xjordanx/q-radio/(commit log)

2024-09-23 Start Praline design based on HackRF One r10
    [baseband.kicad_sch, frontend.kicad_sch, mcu.kicad_sch, praline.kicad_sch]
2024-09-30 Replace CPLD U24 with FPGA U16
    [baseband.kicad_sch, fpga.kicad_sch, frontend.kicad_sch, mcu.kicad_sch, praline.kicad_sch]
2024-09-30 Change PCB stack-up from four layers to six layers
2024-09-30 Update hardware version detection pin strap
    [mcu.kicad_sch]
2024-10-01 Change USB connector J1 to Type-C
    [fpga.kicad_sch, mcu.kicad_sch]
2024-10-01 Remove interior mounting holes
    [frontend.kicad_sch]
2024-10-01 Remove unused headers
    [baseband.kicad_sch, mcu.kicad_sch]
2024-10-01 Improve voltage regulator layout
    [baseband.kicad_sch, mcu.kicad_sch]
2024-10-01 Add slow-start to VAA power switch
    This fixes "the glitch" previously worked around in firmware.
    [baseband.kicad_sch, fpga.kicad_sch, frontend.kicad_sch, mcu.kicad_sch]
2024-10-02 Change main crystal X1 to TCXO
    [baseband.kicad_sch]
2024-10-02 Update ESD diode component selection
    [baseband.kicad_sch, frontend.kicad_sch]
2024-10-02 Clean up minor ERC violations
    [baseband.kicad_sch, fpga.kicad_sch, frontend.kicad_sch, mcu.kicad_sch]
2024-10-03 Add GND zone to front and back layers
2024-10-03 Update component selections
    [baseband.kicad_sch, fpga.kicad_sch, frontend.kicad_sch, mcu.kicad_sch]
2024-10-04 Update SMA connector component and footprint
    [baseband.kicad_sch, frontend.kicad_sch]
2024-10-16 Remove test points from RF section
    [baseband.kicad_sch, frontend.kicad_sch]
2024-10-16 Use 0201s in RF section
    - Use 1 uF capacitors for DC blocking and decoupling
    - Use 3.3 nF capacitors on switch control signals
    [baseband.kicad_sch, fpga.kicad_sch, frontend.kicad_sch, mcu.kicad_sch]
2024-10-17 Correct FPGA_SGPIO signal labels
    [fpga.kicad_sch]
2024-10-25 Clean up radio layout
    [adc-dac.kicad_sch, baseband.kicad_sch, fpga.kicad_sch, frontend.kicad_sch, mcu.kicad_sch, mixer.kicad_sch, praline.kicad_sch]
2024-10-25 Add current limit for antenna port power
    Use pair of inductors as RF choke
    [baseband.kicad_sch, frontend.kicad_sch]
2024-10-25 Fix FPGA VCCPLL source connection
    [fpga.kicad_sch]
2024-11-09 Adopt new convention for DNP designation
    [baseband.kicad_sch, frontend.kicad_sch, mcu.kicad_sch]
2024-11-09 Drive SGPIO clock (SGPIO8) with FPGA
    Previously the clock generator produced three sample clocks, one at the
    sample rate for the AFE (ADC/DAC) also routed to the FPGA, one at double
    the sample rate for SGPIO, and a duplicate SGPIO clock routed to the
    FPGA. Now the clock generator produces only the AFE clock. The FPGA
    drives the SGPIO clock, derived from the AFE clock.
    [adc-dac.kicad_sch, baseband.kicad_sch, fpga.kicad_sch, mcu.kicad_sch]
2024-11-10 Make clock source termination consistent
    [adc-dac.kicad_sch, baseband.kicad_sch, clock.kicad_sch, fpga.kicad_sch, frontend.kicad_sch, mcu.kicad_sch, mixer.kicad_sch, praline.kicad_sch]
2024-12-14 Change microcontroller U23 to LPC4330FET180
    [baseband.kicad_sch, clock.kicad_sch, fpga.kicad_sch, mcu.kicad_sch, mixer.kicad_sch, praline.kicad_sch]
2024-12-14 Change FPGA pin assignments for direct PLL input
    [fpga.kicad_sch]
2024-12-14 Increase outermost DC block to 25 V
    [clock.kicad_sch, fpga.kicad_sch, frontend.kicad_sch, mcu.kicad_sch]
2024-12-14 Use single 15 uH inductor as RF choke
    [frontend.kicad_sch, mixer.kicad_sch]
2024-12-14 Change IF baluns to HHM1946A1
    [baseband.kicad_sch]
2024-12-17 Add overvoltage protection
    [baseband.kicad_sch, fpga.kicad_sch, mcu.kicad_sch, power.kicad_sch, praline.kicad_sch]
2024-12-19 Add more expansion pins
    [clock.kicad_sch, mcu.kicad_sch, praline.kicad_sch]
2024-12-19 Change RF amplifiers U13 and U25 to TRF37C73
    [frontend.kicad_sch]
2024-12-22 Rearrange RF section
    - Use DPDT RF switches to reduce long tracks
    - Add limiter
    - Add switch control logic
    - Move ADC/DAC U18 to RF area
    - Remove baseband header P9
    [adc-dac.kicad_sch, baseband.kicad_sch, clock.kicad_sch, fpga.kicad_sch, frontend.kicad_sch, mcu.kicad_sch, mixer.kicad_sch, power.kicad_sch]
2024-12-22 Ensure LEDs can remain off in low power modes
    - Change "3V3" LED to "MCU" LED4
    - Change "1V2" LED to "FPGA" on 3V3FPGA
    - Make LED control signals active-low
    [mcu.kicad_sch]
2024-12-23 Add current-limiting switch to expansion interface
    [mcu.kicad_sch, power.kicad_sch, praline.kicad_sch]
2024-12-23 Update USB D+/D- TVS and improve routing
    [mcu.kicad_sch]
2024-12-24 Add Type-C controller
    [mcu.kicad_sch, praline.kicad_sch, usb.kicad_sch]
2025-02-05 Change U17 from MAX2837 to MAX2831
    Update version to 0.2.0+
    [adc-dac.kicad_sch, baseband.kicad_sch, clock.kicad_sch, fpga.kicad_sch, frontend.kicad_sch, mcu.kicad_sch, mixer.kicad_sch, power.kicad_sch]
2025-02-08 Change Type-C controller U29 to HUSB328
    - Update USB TVS
    - Improve USB differential impedance
    [mcu.kicad_sch, mixer.kicad_sch, power.kicad_sch, praline.kicad_sch, usb.kicad_sch]
2025-02-11 Change SMA connectors to A-SMA-KE-16.5A
    [clock.kicad_sch, frontend.kicad_sch]
2025-02-12 Change RTC crystal X3 to XKXGI-SUA-32.768K
    [mcu.kicad_sch]
2025-02-12 Consolidate PMOS component selection
    [power.kicad_sch]
2025-02-16 Multiplex clock I/O signals
    - Allow switching of CLKIN and CLKOUT ports to trigger I/O and other signals
    - Add SCT_CLK
    [baseband.kicad_sch, clock.kicad_sch, mcu.kicad_sch, praline.kicad_sch, switch_control.kicad_sch]
2025-02-17 Use lumped element filters for image rejection
    [frontend.kicad_sch]
2025-02-18 Add narrowband anti-aliasing filter
    [adc-dac.kicad_sch, mcu.kicad_sch, praline.kicad_sch]
2025-02-19 Improve baseband TX attenuation options
    [adc-dac.kicad_sch, mcu.kicad_sch, praline.kicad_sch]
2025-02-19 Add TX_EN solder jumper
    [switch_control.kicad_sch]
2025-02-19 Add IF filters
    [frontend.kicad_sch]
2025-02-19 Move USB connector J1 to match HackRF One position
2025-02-20 Connect mixer U4 LD and ENBL pins to MCU
    [adc-dac.kicad_sch, baseband.kicad_sch, clock.kicad_sch, frontend.kicad_sch, image_reject.kicad_sch, mcu.kicad_sch, mixer.kicad_sch, praline.kicad_sch]
2025-02-21 Remove GND zone from front layer F.Cu
    [mcu.kicad_sch, praline.kicad_sch]
2025-02-23 Adjust position of FPGA U16
    [mcu.kicad_sch]
2025-02-24 Move clock generator U19 to 3V3FPGA supply
    [clock.kicad_sch]
2025-02-25 Remove big/little decoupling from ADC/DAC U18
    [adc-dac.kicad_sch]
2025-02-26 Cut vacated area from PCB edge
2025-02-26 AC-couple RX analog baseband
    [adc-dac.kicad_sch, mixer.kicad_sch]
2025-02-28 Increase series resistors to 100 ohms
    [fpga.kicad_sch]
2025-02-28 Improve power supply filtering and decoupling
    [adc-dac.kicad_sch, baseband.kicad_sch, clock.kicad_sch, fpga.kicad_sch, frontend.kicad_sch, image_reject.kicad_sch, mcu.kicad_sch, mixer.kicad_sch]
2025-02-28 Move clock voltage dividers out of shielded area
2025-02-28 Adjust shield footprint for improved routing
    [frontend.kicad_sch]
2025-03-01 Update TVS
    [clock.kicad_sch, frontend.kicad_sch, usb.kicad_sch]
2025-03-03 Update tactile switch SW1, SW2 footprint
    [mcu.kicad_sch]
2025-04-12 Increase VCC from 3.25 V to 3.33 V
    [power.kicad_sch]
2025-04-12 Do not populate narrowband anti-aliasing filter
    [adc-dac.kicad_sch]
2025-04-12 Do not populate baseband DC block
    [adc-dac.kicad_sch]
2025-04-12 Do not populate TXIF attenuator
    [baseband.kicad_sch]
2025-04-15 Reduce antenna bias current limit to 125 mA
    Change all 162k resistors to 180k
    [frontend.kicad_sch, mcu.kicad_sch, power.kicad_sch]
2025-04-16 Update LED component selections and colors
    [mcu.kicad_sch]
2025-04-22 Change L1 from 0201 to 0603
    [mixer.kicad_sch]
2025-04-22 Set TX baseband common-mode voltage with REFIN
    - Do not populate TX baseband voltage divider
    - Remove baseband DC block
    [adc-dac.kicad_sch, mcu.kicad_sch]
2025-04-22 Update narrowband anti-aliasing filter
    - Add second filter with different bandwidth
    - Populate filters
    [adc-dac.kicad_sch, mcu.kicad_sch, praline.kicad_sch]
2025-04-22 Change SP3T RF switches from MXD8638C to BGS13SN8
    [frontend.kicad_sch, image_reject.kicad_sch]
2025-06-01 Update to KiCad 9
    [adc-dac.kicad_sch, baseband.kicad_sch, clock.kicad_sch, fpga.kicad_sch, frontend.kicad_sch, image_reject.kicad_sch, mcu.kicad_sch, mixer.kicad_sch]
2025-06-01 Update XCVR_CLK voltage divider
    [baseband.kicad_sch]
2025-06-01 Update TX IF balun match
    [baseband.kicad_sch]
2025-06-01 Remove TXIF attenuator
    [baseband.kicad_sch]
2025-06-01 Upgrade U20 to W25Q32JVSSIQ
    [mcu.kicad_sch]
2025-06-01 Add side fillet area to SMA connector footprint
2025-06-05 Tune limiter
    [frontend.kicad_sch]
2025-06-05 Add GND cut-out to IF filter footprint
2025-06-05 Widen RF port bias tee frequency range
    [frontend.kicad_sch]
2025-06-05 Update narrowband anti-aliasing filter
    - remove second filter which caused problems
    - increase bandwidth of remaining filter
    - sharpen filter cut-off
    [adc-dac.kicad_sch, mcu.kicad_sch, praline.kicad_sch]
2025-06-06 Change RX RF amplifier to BFR840
    [frontend.kicad_sch, power.kicad_sch]
2025-06-06 Change TX RF amplifier to BGB741
    [frontend.kicad_sch, power.kicad_sch]
2025-06-06 Add mixer loss compensation amplifiers
    [fpga.kicad_sch, frontend.kicad_sch, image_reject.kicad_sch, mcu.kicad_sch, praline.kicad_sch, switch_control.kicad_sch]
2025-06-07 Widen mixer output bias tee frequency range
    [mixer.kicad_sch]
2025-06-07 Add supply FETs to RF amplifiers
    [frontend.kicad_sch, image_reject.kicad_sch]
2025-06-08 Update symbols and footprints
    - Update U21 symbol and footprint
    - Add L10, L11 3D model
    - Add T1, T2 3D model
    - Update U29 footprint
    - Update J10 footprint and part selection, change to TP6
    - Update diode footprints and 3D models
    - Update SMA connector footprint
    - Fix 3D model scale for various footprints
    - Change L1 from 0603 back to 0201
    - Fix pin header 3D models
    - Add component substitutions
    - Update RF switch and amplifier footprints
    - Remove fiducials
    - Update mounting hole symbol and footprint
    [clock.kicad_sch, frontend.kicad_sch, mcu.kicad_sch, mixer.kicad_sch, power.kicad_sch, usb.kicad_sch]
2025-06-08 Add XCVR_CLK and MIX_CLK passive options
    [baseband.kicad_sch, mcu.kicad_sch, mixer.kicad_sch]
2025-06-08 Strengthen MODE and 1V2_EN pull-downs
    [power.kicad_sch]
2025-06-08 Add M2 mounting holes
    [frontend.kicad_sch, power.kicad_sch, praline.kicad_sch]
2025-06-09 Add test points
    [adc-dac.kicad_sch, clock.kicad_sch, fpga.kicad_sch, frontend.kicad_sch, mcu.kicad_sch, power.kicad_sch, switch_control.kicad_sch]
2025-06-09 Use consistent footprints for 0402 and 0201 diodes
    [clock.kicad_sch, frontend.kicad_sch, image_reject.kicad_sch, power.kicad_sch, usb.kicad_sch]
2025-07-02 Correct component metadata
    [adc-dac.kicad_sch, frontend.kicad_sch, mcu.kicad_sch, power.kicad_sch]
2025-07-02 Enlarge board edge cutout
2025-07-04 Change RX RF amplifier to BGB741
    [frontend.kicad_sch]
2025-07-04 Replace mixer compensation amps with single BGB741
    [image_reject.kicad_sch, mixer.kicad_sch, power.kicad_sch, praline.kicad_sch]
2025-07-04 Change TX RF amplifier to TRF37C73
    [frontend.kicad_sch]
2025-07-07 Tune bias tee and limiter
    [frontend.kicad_sch]
2025-07-07 Add FPGA_CLK clock generator output
    - Remove TRIGGER_EN signal, to be replaced with SPI command
    - Reassign clock generator outputs for CLKOUT and CLKIN
    - Reassign various FPGA pins
    [adc-dac.kicad_sch, clock.kicad_sch, fpga.kicad_sch, mcu.kicad_sch, praline.kicad_sch]
2025-07-07 Adjust XCVR_CLK voltage divider
    [baseband.kicad_sch]
2025-07-07 Swap MCU pin assignments for XCVR.LD and XCVR.RXTX
2025-07-07 Adjust 50 ohm trace width
2025-07-08 Standardize component Value fields
    Use Tolerance field instead of expressing tolerance in Value field
    [adc-dac.kicad_sch, baseband.kicad_sch, clock.kicad_sch, fpga.kicad_sch, frontend.kicad_sch, image_reject.kicad_sch, mcu.kicad_sch, mixer.kicad_sch]
2025-07-09 Tune mixer output bias and balun
    [clock.kicad_sch, mcu.kicad_sch, mixer.kicad_sch, usb.kicad_sch]
2025-07-09 Update U4 pull-ups
    [frontend.kicad_sch, mixer.kicad_sch]
2025-08-01 Swap SGPIO0/DISABLE FPGA pins
    [fpga.kicad_sch]
2025-08-03 Tune mixer compensation amp
    [mixer.kicad_sch]
2025-08-03 Connect trigger and PPS I/O signals to MCU
    [clock.kicad_sch, mcu.kicad_sch, praline.kicad_sch]
2025-08-03 Move MCU_CLK from CLK7 to CLK2
    - Move FPGA_CLK from CLK2 to CLK1, shared with SCT_CLK
    - Add AUX_CLK2 on CLK7
    [clock.kicad_sch, mcu.kicad_sch, praline.kicad_sch]
2025-08-04 Add CLKIN selector switch
    - Rename CLKIN SMA connector to P1
    - Rename CLKOUT SMA connector to P2
    - Allow selection of CLKIN from either P1 or P22
    - Add more signals to P1 mux
    [clock.kicad_sch, mcu.kicad_sch, praline.kicad_sch]
2025-08-04 Tune RX RF amp
    [frontend.kicad_sch]
2025-08-04 Add more VAA, 1V2FPGA capacitance
    [fpga.kicad_sch, frontend.kicad_sch]
2025-08-04 Add SPI series resistors
    [fpga.kicad_sch, mcu.kicad_sch]
2025-08-04 Make pin 1 marks consistent
    [clock.kicad_sch, mcu.kicad_sch]
2025-08-04 Move mounting hole H7
    [frontend.kicad_sch]
2025-08-25 Change D13 to PMEG4010ESBYL
    [power.kicad_sch]
2025-08-25 Improve pin 1 marks
2025-08-26 Use mixer compensation amp only for TX
    [mixer.kicad_sch, praline.kicad_sch, switch_control.kicad_sch]
2025-09-24 Use Type-C power instead of Type-C controller
    [mcu.kicad_sch, power.kicad_sch, praline.kicad_sch, usb.kicad_sch]
2025-10-17 Correct R39 component selection
    [mcu.kicad_sch]
2025-10-17 Update RF shield frame J3 component selection
    [praline.kicad_sch]
2025-10-17 Update LED series resistors to balance brightness
    [mcu.kicad_sch, praline.kicad_sch]
2025-10-18 Change SP3T RF switches from BGS13SN8 to MXD8638C
    [frontend.kicad_sch, image_reject.kicad_sch]
2025-11-12 Update component selections
    - Change C143, C147 to 22 uF CL21A226MAYNNNE
    - Change VIN diode D13 to 0 ohm resistor
    - Change R29 to 100 ohm
    - Change limiter Schottky D15 to JDH2S02SL,L3F
    [frontend.kicad_sch, image_reject.kicad_sch, power.kicad_sch]
2026-08-03 Rename project praline -> q-radio
    Project, board, and top-level schematic renamed. Internal references
    updated: project instance names in all schematics, root Sheetfile
    references in the PCB, project meta filename, cvpcb netlist name, and
    TITLE text variable. The 'praline' symbol/footprint/3D library
    nicknames are intentionally unchanged so no symbol or footprint links
    break.
    [adc-dac.kicad_sch, baseband.kicad_sch, clock.kicad_sch, fpga.kicad_sch, frontend.kicad_sch, image_reject.kicad_sch, mcu.kicad_sch, mixer.kicad_sch]
2026-08-03 Add Quilter candidate management: archive, manifest, scripts, workflow guide
    - candidates/: quarantine archive for pristine Quilter downloads + manifest.yaml ledger
    - scripts/quilter-send.sh: tag the exact snapshot uploaded to Quilter
    - scripts/quilter-import.sh: archive candidate, record UUIDs, branch, and
    install it as the live q-radio.kicad_pcb in one step
    - .gitattributes: forbid auto-merge of board/schematic files; union-merge manifest
    - .gitignore: KiCad backups, autosaves, locks, per-user settings
    - docs/WORKFLOW.md: beginner git guide with data-flow diagrams
2026-08-04 docs: add schematic variant workflow (testpoint removal via variant/* branches)
    - assembly variants (DNP) stay on main; design variants get variant/<name>
    branches between main and quilter/* experiments
    - recommend 'Exclude from board' attribute flips over symbol deletion
    - variant-aware winner promotion guidance
2026-08-11 Add PowerShell script twins; pin *.sh to LF endings
    quilter-send.ps1 / quilter-import.ps1 are direct translations of the
    bash scripts (Windows PowerShell 5.1 compatible). .gitattributes now
    forces LF on *.sh so autocrlf checkouts can't break bash again
    ('set: pipefail\r: invalid option'), and CRLF on *.ps1.
2026-08-11 Pin KiCad file types to LF endings
2026-08-11 KiCad 10 format upgrade via kicad-cli (schematics, board, symbol and footprint libraries)
    [adc-dac.kicad_sch, baseband.kicad_sch, clock.kicad_sch, fpga.kicad_sch, frontend.kicad_sch, image_reject.kicad_sch, mcu.kicad_sch, mixer.kicad_sch]
2026-08-12 docs: add Flow F -- baseline experiment branch + candidate sub-branches
    - git checkout -b explained explicitly (create-then-switch, optional start point)
    - branch-BEFORE-editing rule of thumb
    - full pattern: exp/<name> baseline -> quilter/<job8> sub-branches ->
    winner merges into baseline -> experiment promotes to variant/main
    - cheat sheet entries for the new flow
2026-08-12 Upgrade project file settings to KiCad 10 schema
2026-08-12 Add KiCad console scripts: selected-footprint placement export/apply
    export_selected_placement.py writes ref/x/y/rot/side of SELECTED
    footprints to placement.csv; apply_placement.py moves matching refs on
    the open board. For copying partial placement between variants of the
    same design (built-in .pos export has no selection filter).
    placement.csv gitignored as scratch.
2026-08-12 Add clipboard-based placement export (Ctrl+C selection -> placement.csv)
    Discovery: pcbnew's Ctrl+C puts the selection's s-expression on the
    clipboard. clipboard_placement.py parses it (pure text, any Python 3);
    clipboard-to-placement.ps1 wraps Get-Clipboard -> placement.csv. Lighter
    alternative to the scripting-console export; apply_placement.py consumes
    the same CSV on the target board.
2026-08-12 Make KiCad placement tools standalone; move next to WORKFLOW.md in docs/
    Project-agnostic: no hardcoded repo paths, ps1 wrapper no longer needs
    git (parser located via PSScriptRoot, CSV written to current dir).
    Intended to also live in the user's KiCad scripting folder so they work
    in any project regardless of branch. Untracked stray __pycache__.
2026-08-12 docs: point placement tool headers at the shared scripting dir
    Shared, project-agnostic automations live in
    C:\ECAD\KiCad\10.0\share\kicad\scripting\ per Ben's convention.
2026-08-13 quilter-import: accept Quilter zip downloads; archive as moved zips
    - .zip input: validated (exactly one .kicad_pcb inside), the zip is
    MOVED into candidates/<job8>/ untouched, board extracted and installed
    - .kicad_pcb input: zipped first, zip archived, loose original removed
    after success (preserved in archive + live board)
    - manifest gains candidate_pcb field; commit gains Quilter-Archive trailer
    - .gitignore: un-ignore candidates/**/*.zip (global *.zip rule was
    silently blocking archives)
    - .sh and .ps1 twins updated identically; .sh tested end-to-end (zip,
    loose, multi-pcb rejection); cheat sheet: how to find the latest q-sent tag
2026-08-13 quilter-import: default snapshot tag is branch-aware
    Prefer the newest q-sent tag REACHABLE from the current branch
    (git tag --merged HEAD), so parallel experiments' tags on other
    branches can no longer be picked by accident. Falls back to the
    newest tag overall only when none is reachable, with a loud notice.
    Also prints the tag's commit so mistakes are visible before commit.
    Cheat sheet updated with branch-scoped tag lookup.
2026-08-13 quilter-import: survive [brackets] in Quilter's zip filenames
    Quilter names downloads like Quilter_QRadio_[var_tp-none]_Candidate_3.zip.
    Square brackets are wildcard characters to some unzip implementations and
    to git pathspecs, which broke extraction ('no .kicad_pcb inside') and
    could break staging. Fix: extract from a plain-named temp copy, and stage
    the archive by directory instead of by filename. Both twins. Tested
    end-to-end with the exact bracketed name.
2026-08-13 quilter-import: make PowerShell zip fallback work without cygpath
    MobaXterm has neither unzip nor cygpath, so the fallback handed
    PowerShell a /tmp/... path Windows cannot see. Temp workspace now lives
    inside the repo (real drive-letter path, gitignored .qimport-tmp.*),
    input path is absolutized, and to_native() hand-converts /drives/X/,
    /cygdrive/X/ and /X/ prefixes when cygpath is absent.
2026-08-13 quilter-import: refuse cross-branch snapshot-tag fallback
    A candidate imported with another experiment's tag gets grafted onto the
    wrong parent (wrong schematics, wrong provenance) -- this happened once.
    Now, if no q-sent tag is reachable from the current branch, the import
    STOPS and explains the two remedies (switch branch, or retro-tag /
    -s explicitly) instead of guessing.
