xjordanx/q-radio/mcu.kicad_sch

## KiCad design mcu.kicad_sch (2026-08-11)

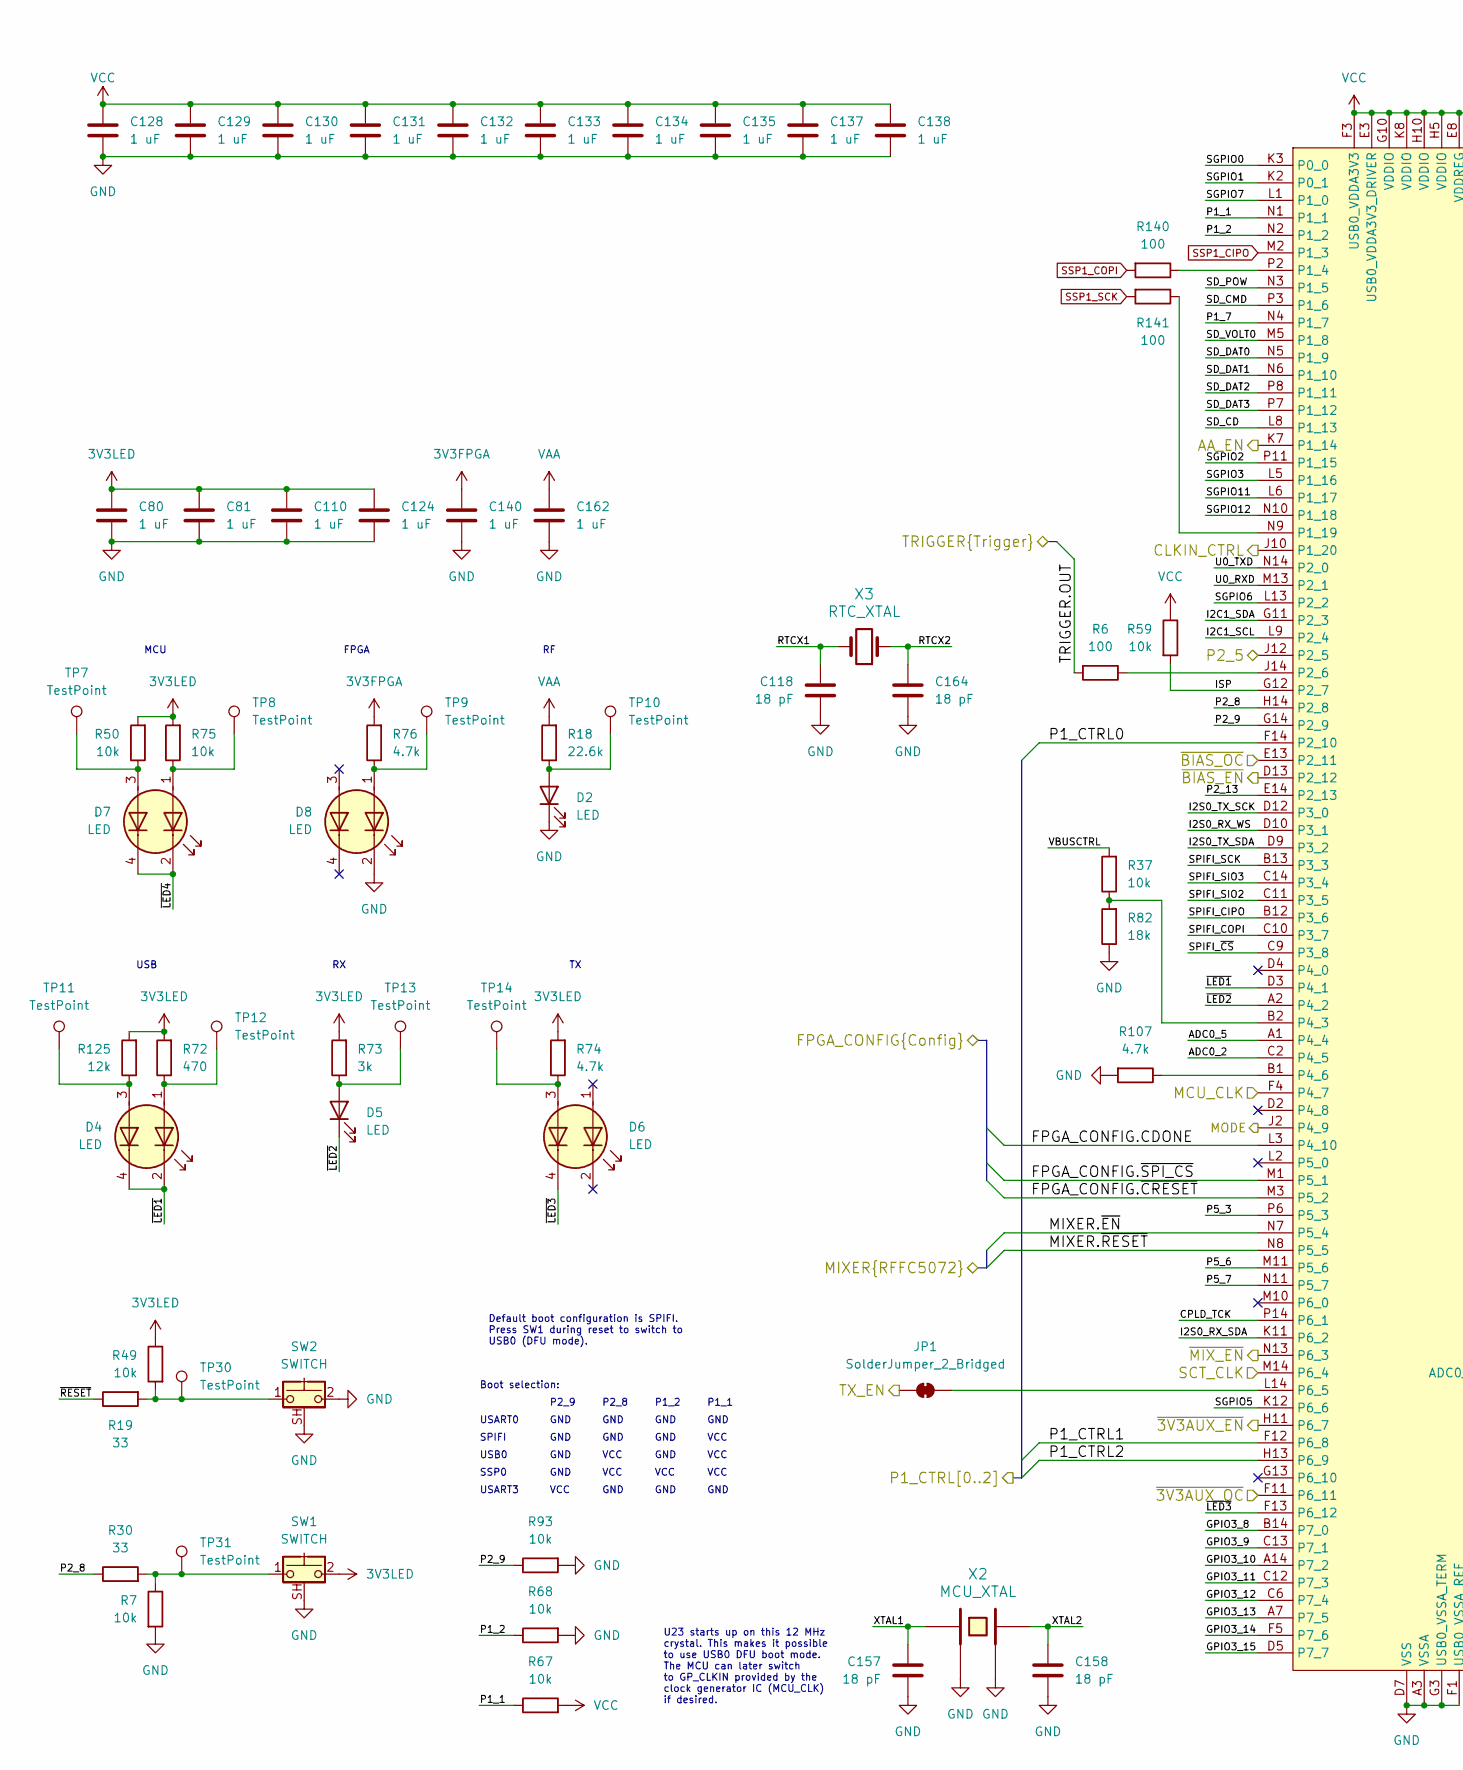
[picture p7: schematic mcu.kicad_sch, part in row 1, column 1]

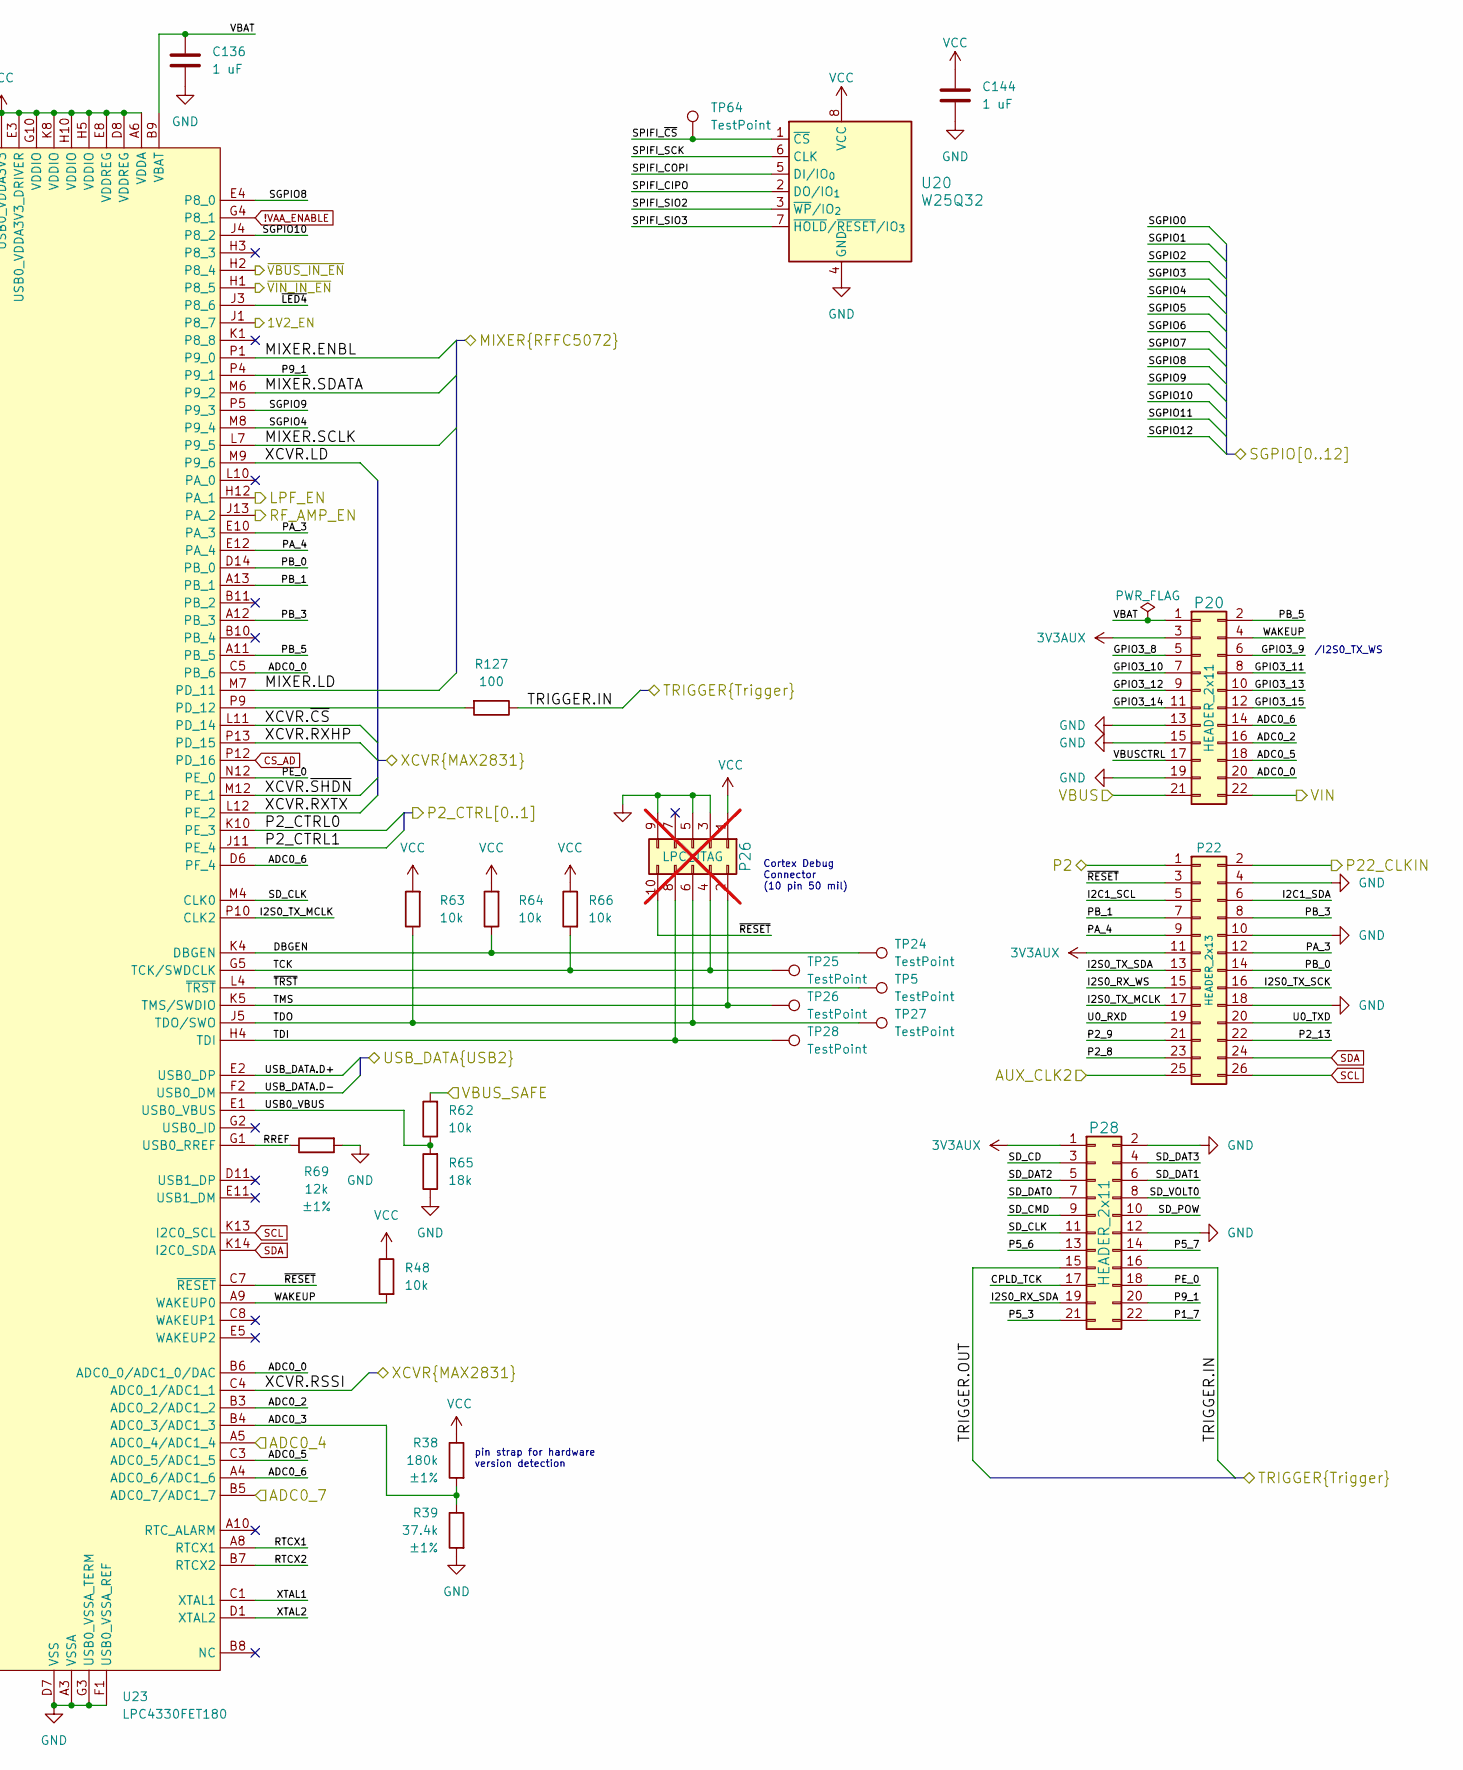
[picture p8: schematic mcu.kicad_sch, part in row 1, column 2]

Parts:
C80, C81, C110, C124, C128, C129, C130, C131, C132, C133, C134, C135, C136, C137, C138, C140, C144, C162: 1 uF; C_0402_1005Metric; Part Number CL05A105KA5NQNC
C118, C157, C158, C164: 18 pF; C_0402_1005Metric; Part Number CL05C180JB5NNNC
D2: LED; LED_Single_Xinglight_XL-3210_Horizontal; Part Number XL-3210UGC
D4: LED; LED_Dual_Xinglight_XL-3210_Horizontal; Part Number XL-3210SURSYGC
D5: LED; LED_Single_Xinglight_XL-3210_Horizontal; Part Number XL-3210UOC
D6, D7, D8: LED; LED_Dual_Xinglight_XL-3210_Horizontal; Part Number XL-3210SURUBC
JP1: SolderJumper_2_Bridged; SolderJumper-2_P1.3mm_Bridged_RoundedPad1.0x1.5mm
P20, P28: HEADER_2x11; PinSocket_2x11_P2.54mm_Vertical_Flipped; Part Number PPPC112LFBN-RC
P22: HEADER_2x13; PinSocket_2x13_P2.54mm_Vertical_Flipped; Part Number PPPC132LFBN-RC
P26: LPC_JTAG; PinHeader_2x05_P1.27mm_Vertical; Part Number GRPB052VWVN-RC; not fitted
R6, R127, R140, R141: 100; R_0201_0603Metric; Part Number RC0201JR-07100RL
R7, R37, R48, R49, R50, R59, R62, R63, R64, R66, R67, R68, R75, R93: 10k; R_0402_1005Metric; Part Number RC0402JR-0710KL
R18: 22.6k; R_0201_0603Metric; Part Number RC0201FR-0722K6L
R19, R30: 33; R_0201_0603Metric; Part Number RC0201JR-0733RL
R38: 180k; R_0402_1005Metric; Tolerance ±1%; Part Number RC0402FR-07180KL
R39: 37.4k; R_0402_1005Metric; Tolerance ±1%; Part Number RC0402FR-0737K4L
R65, R82: 18k; R_0402_1005Metric; Part Number RC0402JR-0718KL
R69: 12k; R_0201_0603Metric; Tolerance ±1%; Part Number RC0201FR-0712KL
R72: 470; R_0201_0603Metric; Part Number RC0201JR-07470RL
R73: 3k; R_0402_1005Metric; Part Number RC0402JR-073KL
R74, R76, R107: 4.7k; R_0201_0603Metric; Part Number RC0201FR-074K7L
R125: 12k; R_0201_0603Metric; Part Number RC0201FR-0712KL
SW1, SW2: SWITCH; SW_Tactile_SPST_Angled_PTS645Vx58-2LFS; Part Number FSMRA3JH
TP5, TP7, TP8, TP9, TP10, TP11, TP12, TP13, TP14, TP24, TP25, TP26, TP27, TP28, TP30, TP31, TP64: TestPoint; TestPoint_Pad_D1.0mm
U20: W25Q32; SOIC-8_5.3x5.3mm_P1.27mm; Part Number W25Q32JVSSIQ
U23: LPC4330FET180; TFBGA-180_12x12mm_Layout14x14_P0.8mm; Part Number LPC4330FET180
X2: MCU_XTAL; Crystal_SMD_3225-4Pin_3.2x2.5mm; Part Number SX3B12.000F1210F30
X3: RTC_XTAL; Crystal_SMD_3215-2Pin_3.2x1.5mm; Part Number XKXGI-SUA-32.768K

Connections:
1V2_EN: U23.J1 (P8_7)
3V3AUX: P20.3, P22.11, P28.1
3V3FPGA: C140.1, R76.2
3V3LED: C80.1, C81.1, C110.1, C124.1, R49.1, R50.2, R72.2, R73.2, R74.2, R75.2, R125.2, SW1.2
!VAA_ENABLE: U23.G4 (P8_1)
AA_EN: U23.K7 (P1_14)
ADC0_0: P20.20, U23.B6 (ADC0_0/ADC1_0/DAC), U23.C5 (PB_6)
ADC0_2: P20.16, U23.B3 (ADC0_2/ADC1_2), U23.C2 (P4_5)
ADC0_3: R38.2, R39.1, U23.B4 (ADC0_3/ADC1_3)
ADC0_4: U23.A5 (ADC0_4/ADC1_4)
ADC0_5: P20.18, U23.A1 (P4_4), U23.C3 (ADC0_5/ADC1_5)
ADC0_6: P20.14, U23.A4 (ADC0_6/ADC1_6), U23.D6 (PF_4)
ADC0_7: U23.B5 (ADC0_7/ADC1_7)
AUX_CLK2: P22.25
CLKIN_CTRL: U23.J10 (P1_20)
CPLD_TCK: P28.17, U23.P14 (P6_1)
CS_AD: U23.P12 (PD_16)
DBGEN: R64.1, TP24.1, U23.K4 (DBGEN)
FPGA_CONFIG.CDONE: U23.L3 (P4_10)
FPGA_CONFIG.~CRESET: U23.M3 (P5_2)
FPGA_CONFIG.~SPI_CS: U23.M1 (P5_1)
GND: C80.2, C81.2, C110.2, C118.2, C124.2, C128.2, C129.2, C130.2, C131.2, C132.2, C133.2, C134.2, C135.2, C136.2, C137.2, C138.2, C140.2, C144.2, C157.2, C158.2, C162.2, C164.2, D2.1 (K), D8.2 (K1), P20.13, P20.15, P20.19, P22.4, P22.10, P22.18, P26.3, P26.5, P26.9, P28.2, P28.12, R7.2, R39.2, R65.1, R68.2, R69.2, R82.1, R93.2, R107.2, SW1.SH (B), SW2.2, SW2.SH (B), U20.4 (GND), U23.A3 (VSSA), U23.D7 (VSS), U23.E6 (VSS), U23.E7 (VSS), U23.E9 (VSS), U23.F1 (USB0_VSSA_REF), U23.F10 (VSS), U23.G3 (USB0_VSSA_TERM), U23.K6 (VSS), U23.K9 (VSS), X2.2, X2.4
GPIO3_8: P20.5, U23.B14 (P7_0)
GPIO3_9: P20.6, U23.C13 (P7_1)
GPIO3_10: P20.7, U23.A14 (P7_2)
GPIO3_11: P20.8, U23.C12 (P7_3)
GPIO3_12: P20.9, U23.C6 (P7_4)
GPIO3_13: P20.10, U23.A7 (P7_5)
GPIO3_14: P20.11, U23.F5 (P7_6)
GPIO3_15: P20.12, U23.D5 (P7_7)
I2C1_SCL: P22.5, U23.L9 (P2_4)
I2C1_SDA: P22.6, U23.G11 (P2_3)
I2S0_RX_SDA: P28.19, U23.K11 (P6_2)
I2S0_RX_WS: P22.15, U23.D10 (P3_1)
I2S0_TX_MCLK: P22.17, U23.P10 (CLK2)
I2S0_TX_SCK: P22.16, U23.D12 (P3_0)
I2S0_TX_SDA: P22.13, U23.D9 (P3_2)
ISP: R59.2, U23.G12 (P2_7)
LPF_EN: U23.H12 (PA_1)
MCU_CLK: U23.F4 (P4_7)
MIXER.ENBL: U23.P1 (P9_0)
MIXER.LD: U23.M7 (PD_11)
MIXER.SCLK: U23.L7 (P9_5)
MIXER.SDATA: U23.M6 (P9_2)
MIXER.~EN: U23.N7 (P5_4)
MIXER.~RESET: U23.N8 (P5_5)
MODE: U23.J2 (P4_9)
unnamed: D2.2 (A), R18.1, TP10.1
unnamed: D4.1 (A1), R72.1, TP12.1
unnamed: D4.3 (A2), R125.1, TP11.1
unnamed: D5.2 (A), R73.1, TP13.1
unnamed: D6.3 (A2), R74.1, TP14.1
unnamed: D7.1 (A1), R75.1, TP8.1
unnamed: D7.3 (A2), R50.1, TP7.1
unnamed: D8.1 (A1), R76.1, TP9.1
unnamed: JP1.1 (A), U23.L14 (P6_5)
unnamed: R6.1, U23.J14 (P2_6)
unnamed: R19.2, R49.2, SW2.1, TP30.1
unnamed: R7.1, R30.2, SW1.1, TP31.1
unnamed: R37.1, R82.2, U23.B2 (P4_3)
unnamed: R107.1, U23.B1 (P4_6)
unnamed: R127.2, U23.P9 (PD_12)
unnamed: R140.1, U23.P2 (P1_4)
unnamed: R141.1, U23.N9 (P1_19)
P1_1: R67.1, U23.N1 (P1_1)
P1_2: R68.1, U23.N2 (P1_2)
P1_7: P28.22, U23.N4 (P1_7)
P1_CTRL0: U23.F14 (P2_10)
P1_CTRL1: U23.F12 (P6_8)
P1_CTRL2: U23.H13 (P6_9)
P2: P22.1
P2_5: U23.J12 (P2_5)
P2_8: P22.23, R30.1, U23.H14 (P2_8)
P2_9: P22.21, R93.1, U23.G14 (P2_9)
P2_13: P22.22, U23.E14 (P2_13)
P2_CTRL0: U23.K10 (PE_3)
P2_CTRL1: U23.J11 (PE_4)
P5_3: P28.21, U23.P6 (P5_3)
P5_6: P28.13, U23.M11 (P5_6)
P5_7: P28.14, U23.N11 (P5_7)
P9_1: P28.20, U23.P4 (P9_1)
P22_CLKIN: P22.2
PA_3: P22.12, U23.E10 (PA_3)
PA_4: P22.9, U23.E12 (PA_4)
PB_0: P22.14, U23.D14 (PB_0)
PB_1: P22.7, U23.A13 (PB_1)
PB_3: P22.8, U23.A12 (PB_3)
PB_5: P20.2, U23.A11 (PB_5)
PE_0: P28.18, U23.N12 (PE_0)
RF_AMP_EN: U23.J13 (PA_2)
RREF: R69.1, U23.G1 (USB0_RREF)
RTCX1: C118.1, U23.A8 (RTCX1), X3.2
RTCX2: C164.1, U23.B7 (RTCX2), X3.1
SCL: P22.26, U23.K13 (I2C0_SCL)
SCT_CLK: U23.M14 (P6_4)
SDA: P22.24, U23.K14 (I2C0_SDA)
SD_CD: P28.3, U23.L8 (P1_13)
SD_CLK: P28.11, U23.M4 (CLK0)
SD_CMD: P28.9, U23.P3 (P1_6)
SD_DAT0: P28.7, U23.N5 (P1_9)
SD_DAT1: P28.6, U23.N6 (P1_10)
SD_DAT2: P28.5, U23.P8 (P1_11)
SD_DAT3: P28.4, U23.P7 (P1_12)
SD_POW: P28.10, U23.N3 (P1_5)
SD_VOLT0: P28.8, U23.M5 (P1_8)
SGPIO0: U23.K3 (P0_0)
SGPIO1: U23.K2 (P0_1)
SGPIO2: U23.P11 (P1_15)
SGPIO3: U23.L5 (P1_16)
SGPIO4: U23.M8 (P9_4)
SGPIO5: U23.K12 (P6_6)
SGPIO6: U23.L13 (P2_2)
SGPIO7: U23.L1 (P1_0)
SGPIO8: U23.E4 (P8_0)
SGPIO9: U23.P5 (P9_3)
SGPIO10: U23.J4 (P8_2)
SGPIO11: U23.L6 (P1_17)
SGPIO12: U23.N10 (P1_18)
SPIFI_CIPO: U20.2 (DO/IO_{1}), U23.B12 (P3_6)
SPIFI_COPI: U20.5 (DI/IO_{0}), U23.C10 (P3_7)
SPIFI_SCK: U20.6 (CLK), U23.B13 (P3_3)
SPIFI_SIO2: U20.3 (~WP/IO_{2}), U23.C11 (P3_5)
SPIFI_SIO3: U20.7 (~HOLD/~RESET/IO_{3}), U23.C14 (P3_4)
SPIFI_~CS: TP64.1, U20.1 (~CS), U23.C9 (P3_8)
SSP1_CIPO: U23.M2 (P1_3)
SSP1_COPI: R140.2
SSP1_SCK: R141.2
TCK: P26.4, R66.2, TP25.1, U23.G5 (TCK/SWDCLK)
TDI: P26.8, TP28.1, U23.H4 (TDI)
TDO: P26.6, R63.1, TP27.1, U23.J5 (TDO/SWO)
TMS: P26.2, TP26.1, U23.K5 (TMS/SWDIO)
TRIGGER.IN: P28.16, R127.1
TRIGGER.OUT: P28.15, R6.2
TX_EN: JP1.2 (B)
U0_RXD: P22.19, U23.M13 (P2_1)
U0_TXD: P22.20, U23.N14 (P2_0)
USB0_VBUS: R62.1, R65.2, U23.E1 (USB0_VBUS)
USB_DATA.D+: U23.E2 (USB0_DP)
USB_DATA.D-: U23.F2 (USB0_DM)
VAA: C162.1, R18.2
VBAT: C136.1, P20.1, U23.B9 (VBAT)
VBUS: P20.21
VBUSCTRL: P20.17, R37.2
VBUS_SAFE: R62.2
VCC: C128.1, C129.1, C130.1, C131.1, C132.1, C133.1, C134.1, C135.1, C137.1, C138.1, C144.1, P26.1, R38.1, R48.1, R59.1, R63.2, R64.2, R66.1, R67.2, U20.8 (VCC), U23.A6 (VDDA), U23.D8 (VDDREG), U23.E3 (USB0_VDDA3V3_DRIVER), U23.E8 (VDDREG), U23.F3 (USB0_VDDA3V3), U23.G10 (VDDIO), U23.H5 (VDDIO), U23.H10 (VDDIO), U23.K8 (VDDIO)
VIN: P20.22
WAKEUP: P20.4, R48.2, U23.A9 (WAKEUP0)
XCVR.LD: U23.M9 (P9_6)
XCVR.RSSI: U23.C4 (ADC0_1/ADC1_1)
XCVR.RXHP: U23.P13 (PD_15)
XCVR.RXTX: U23.L12 (PE_2)
XCVR.~CS: U23.L11 (PD_14)
XCVR.~SHDN: U23.M12 (PE_1)
XTAL1: C157.1, U23.C1 (XTAL1), X2.1
XTAL2: C158.1, U23.D1 (XTAL2), X2.3
~3V3AUX_EN: U23.H11 (P6_7)
~3V3AUX_OC: U23.F11 (P6_11)
~BIAS_EN: U23.D13 (P2_12)
~BIAS_OC: U23.E13 (P2_11)
~LED1: D4.2 (K1), D4.4 (K2), U23.D3 (P4_1)
~LED2: D5.1 (K), U23.A2 (P4_2)
~LED3: D6.4 (K2), U23.F13 (P6_12)
~LED4: D7.2 (K1), D7.4 (K2), U23.J3 (P8_6)
~MIX_EN: U23.N13 (P6_3)
~RESET: P22.3, P26.10, R19.1, U23.C7 (~RESET)
~TRST: TP5.1, U23.L4 (~TRST)
~VBUS_IN_EN: U23.H2 (P8_4)
~VIN_IN_EN: U23.H1 (P8_5)

Notes on the sheet:
GND
VCC
Default boot configuration is SPIFI. Press SW1 during reset to switch to USB0 (DFU mode).
USB0
Boot selection:
pin strap for hardware version detection
USB
/I2S0_TX_WS
USART0
SSP0
FPGA
P2_8
P1_1
P2_9
USART3
Cortex Debug Connector (10 pin 50 mil)
P1_2
U23 starts up on this 12 MHz crystal. This makes it possible to use USB0 DFU boot mode. The MCU can later switch to GP_CLKIN provided by the clock generator IC (MCU_CLK) if desired.
SPIFI
MCU
