xjordanx/q-radio/mixer.kicad_sch

## KiCad design mixer.kicad_sch (2026-08-11)

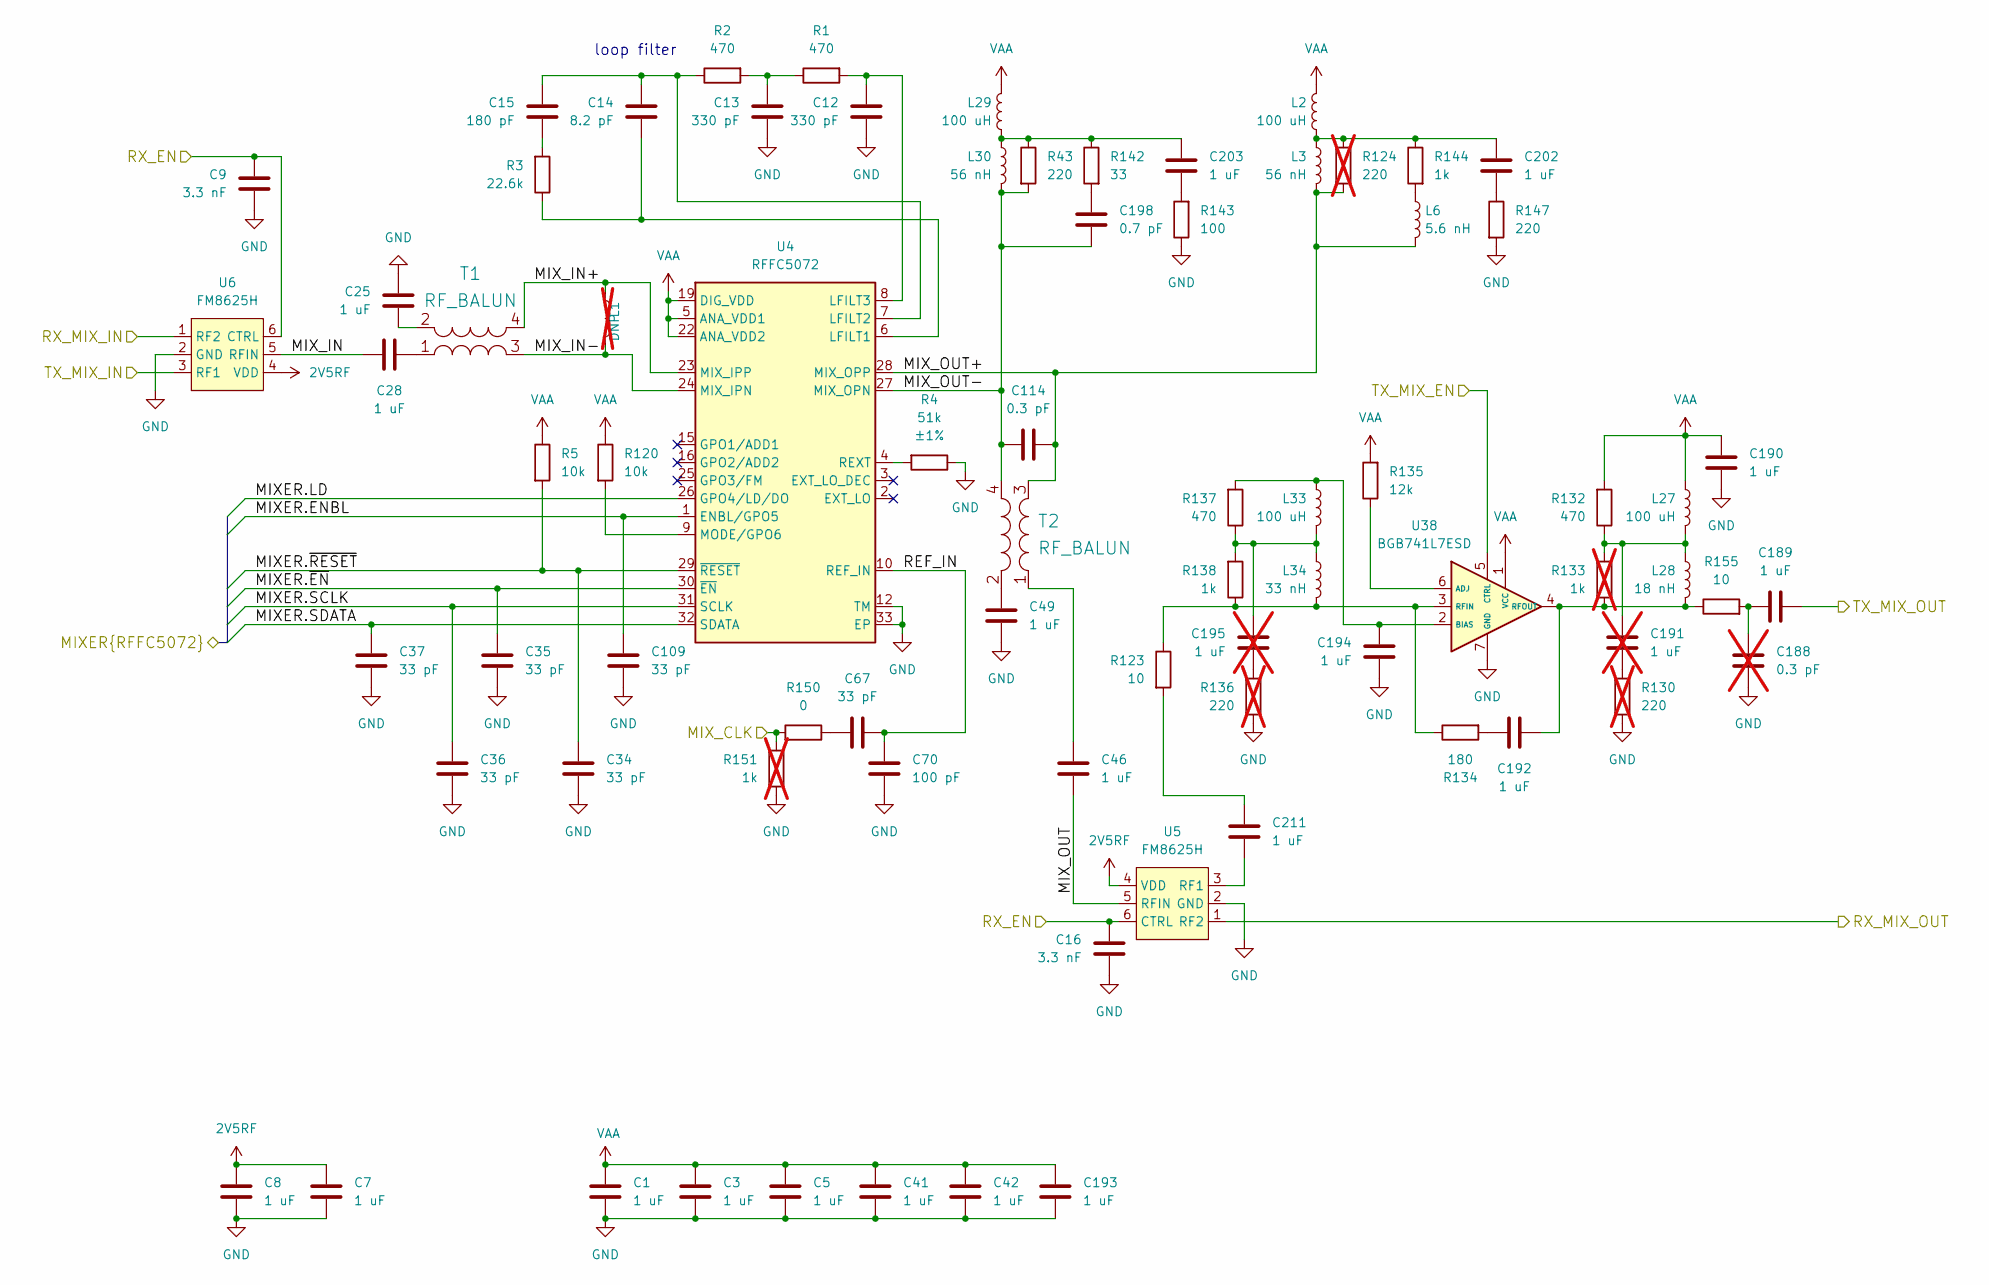
[picture p9: schematic mixer.kicad_sch]

Parts:
C1, C3, C5, C7, C8, C25, C28, C41, C42, C46, C49, C189, C190, C192, C193, C194, C202, C203, C211: 1 uF; C_0201_0603Metric; Part Number GRM033R61A105ME44D
C9, C16: 3.3 nF; C_0201_0603Metric; Part Number GRM033R71A332KA01D
C12, C13: 330 pF; C_0201_0603Metric; Part Number GRM0335C1E331JA01D
C14: 8.2 pF; C_0201_0603Metric; Part Number GRM0335C1H8R2CA01D
C15: 180 pF; C_0201_0603Metric; Part Number GRM0335C1H181JA01D
C34, C35, C36, C37, C67, C109: 33 pF; C_0201_0603Metric; Part Number GRM0335C1H330JA01D
C70: 100 pF; C_0201_0603Metric; Part Number GRM0335C1E101JA01D
C114: 0.3 pF; C_0201_0603Metric; Part Number GRM0335C1ER30BA01D
C188: 0.3 pF; C_0201_0603Metric; Part Number GRM0335C1ER30BA01D; not fitted
C191, C195: 1 uF; C_0201_0603Metric; Part Number GRM033R61A105ME44D; not fitted
C198: 0.7 pF; C_0201_0603Metric; Part Number GRM0335C1ER70WA01D
L1: DNP; L_0201_0603Metric; not fitted
L2, L27, L29, L33: 100 uH; L_TDK_MLZ2012_h1.25mm; Part Number MLZ2012N101LT000
L3, L30: 56 nH; L_0201_0603Metric; Part Number LQP03TN56NJ02D
L6: 5.6 nH; L_0201_0603Metric; Part Number LQP03TN5N6H02D
L28: 18 nH; L_0201_0603Metric; Part Number LQP03TN18NJ02D
L34: 33 nH; L_0201_0603Metric; Part Number LQP03TN33NJ02D
R1, R2, R132, R137: 470; R_0201_0603Metric; Part Number RC0201JR-07470RL
R3: 22.6k; R_0201_0603Metric; Part Number RC0201FR-0722K6L
R4: 51k; R_0201_0603Metric; Tolerance ±1%; Part Number RC0201FR-0751KL
R5, R120: 10k; R_0402_1005Metric; Part Number RC0402JR-0710KL
R43, R147: 220; R_0201_0603Metric; Part Number RC0201JR-07220RL
R123, R155: 10; R_0201_0603Metric; Part Number RC0201JR-0710RL
R124, R130, R136: 220; R_0201_0603Metric; Part Number RC0201JR-07220RL; not fitted
R133, R151: 1k; R_0201_0603Metric; Part Number RC0201FR-071KL; not fitted
R134: 180; R_0201_0603Metric; Part Number RC0201JR-07180RL
R135: 12k; R_0201_0603Metric; Part Number RC0201FR-0712KL
R138, R144: 1k; R_0201_0603Metric; Part Number RC0201FR-071KL
R142: 33; R_0201_0603Metric; Part Number RC0201JR-0733RL
R143: 100; R_0201_0603Metric; Part Number RC0201JR-07100RL
R150: 0; R_0201_0603Metric; Part Number RC0201JR-070RL
T1, T2: RF_BALUN; Anaren_0805_2012Metric-6; Part Number B0310J50100AHF
U4: RFFC5072; QFN-32-1EP_5x5mm_P0.5mm_EP3.7x3.7mm_ThermalVias; Part Number RFFC5072TR7
U5, U6: FM8625H; TSLP-6-4_1.1x0.7mm_P0.4mm; Part Number FM8625H
U38: BGB741L7ESD; TSLP-7-1; Part Number BGB741L7ESDE6327XTSA1

Connections:
2V5RF: C7.1, C8.1, U5.4 (VDD), U6.4 (VDD)
GND: C1.2, C3.2, C5.2, C7.2, C8.2, C9.1, C12.2, C13.2, C16.1, C25.2, C34.2, C35.2, C36.2, C37.2, C41.2, C42.2, C49.1, C70.2, C109.2, C188.2, C190.2, C193.2, C194.2, R4.1, R130.1, R136.1, R143.1, R147.2, R151.2, U4.12 (TM), U4.33 (EP), U5.2 (GND), U6.2 (GND), U38.7 (GND)
MIXER.ENBL: C109.1, U4.1 (ENBL/GPO5)
MIXER.LD: U4.26 (GPO4/LD/DO)
MIXER.SCLK: C36.1, U4.31 (SCLK)
MIXER.SDATA: C37.1, U4.32 (SDATA)
MIXER.~EN: C35.1, U4.30 (~EN)
MIXER.~RESET: C34.1, R5.2, U4.29 (~RESET)
MIX_CLK: R150.2, R151.1
MIX_IN: C28.2, U6.5 (RFIN)
MIX_IN+: L1.1, T1.4 (PR2), U4.23 (MIX_IPP)
MIX_IN-: L1.2, T1.3 (PR1), U4.24 (MIX_IPN)
MIX_OUT: C46.1, U5.5 (RFIN)
MIX_OUT+: C114.2, L3.2, L6.2, R124.2, T2.3 (PR1), U4.28 (MIX_OPP)
MIX_OUT-: C114.1, C198.1, L30.2, R43.2, T2.4 (PR2), U4.27 (MIX_OPN)
unnamed: C12.1, R1.2, U4.8 (LFILT3)
unnamed: C13.1, R1.1, R2.2
unnamed: C14.1, C15.1, R2.1, U4.7 (LFILT2)
unnamed: C14.2, R3.1, U4.6 (LFILT1)
unnamed: C15.2, R3.2
unnamed: C25.1, T1.2 (S2)
unnamed: C28.1, T1.1 (S1)
unnamed: C46.2, T2.1 (S1)
unnamed: C49.2, T2.2 (S2)
unnamed: C67.1, R150.1
unnamed: C188.1, C189.2, R155.2
unnamed: C191.1, L27.2, L28.1, R132.1, R133.2
unnamed: C191.2, R130.2
unnamed: C192.1, L28.2, R133.1, R155.1, U38.4 (RFOUT)
unnamed: C192.2, R134.2
unnamed: C194.1, L33.1, R137.2, U38.2 (BIAS)
unnamed: C195.1, L33.2, L34.1, R137.1, R138.2
unnamed: C195.2, R136.2
unnamed: C198.2, R142.2
unnamed: C202.1, R147.1
unnamed: C202.2, L2.2, L3.1, R124.1, R144.1
unnamed: C203.1, L29.2, L30.1, R43.1, R142.1
unnamed: C203.2, R143.2
unnamed: C211.1, U5.3 (RF1)
unnamed: C211.2, R123.2
unnamed: L6.1, R144.2
unnamed: L34.2, R123.1, R134.1, R138.1, U38.3 (RFIN)
unnamed: R4.2, U4.4 (REXT)
unnamed: R120.2, U4.9 (MODE/GPO6)
unnamed: R135.1, U38.6 (ADJ)
REF_IN: C67.2, C70.1, U4.10 (REF_IN)
RX_EN: C9.2, C16.2, U5.6 (CTRL), U6.6 (CTRL)
RX_MIX_IN: U6.1 (RF2)
RX_MIX_OUT: U5.1 (RF2)
TX_MIX_EN: U38.5 (CTRL)
TX_MIX_IN: U6.3 (RF1)
TX_MIX_OUT: C189.1
VAA: C1.1, C3.1, C5.1, C41.1, C42.1, C190.1, C193.1, L2.1, L27.1, L29.1, R5.1, R120.1, R132.2, R135.2, U4.5 (ANA_VDD1), U4.19 (DIG_VDD), U4.22 (ANA_VDD2), U38.1 (VCC)

Notes on the sheet:
loop filter
