xjordanx/q-radio/switch_control.kicad_sch

## KiCad design switch_control.kicad_sch (2026-08-11)

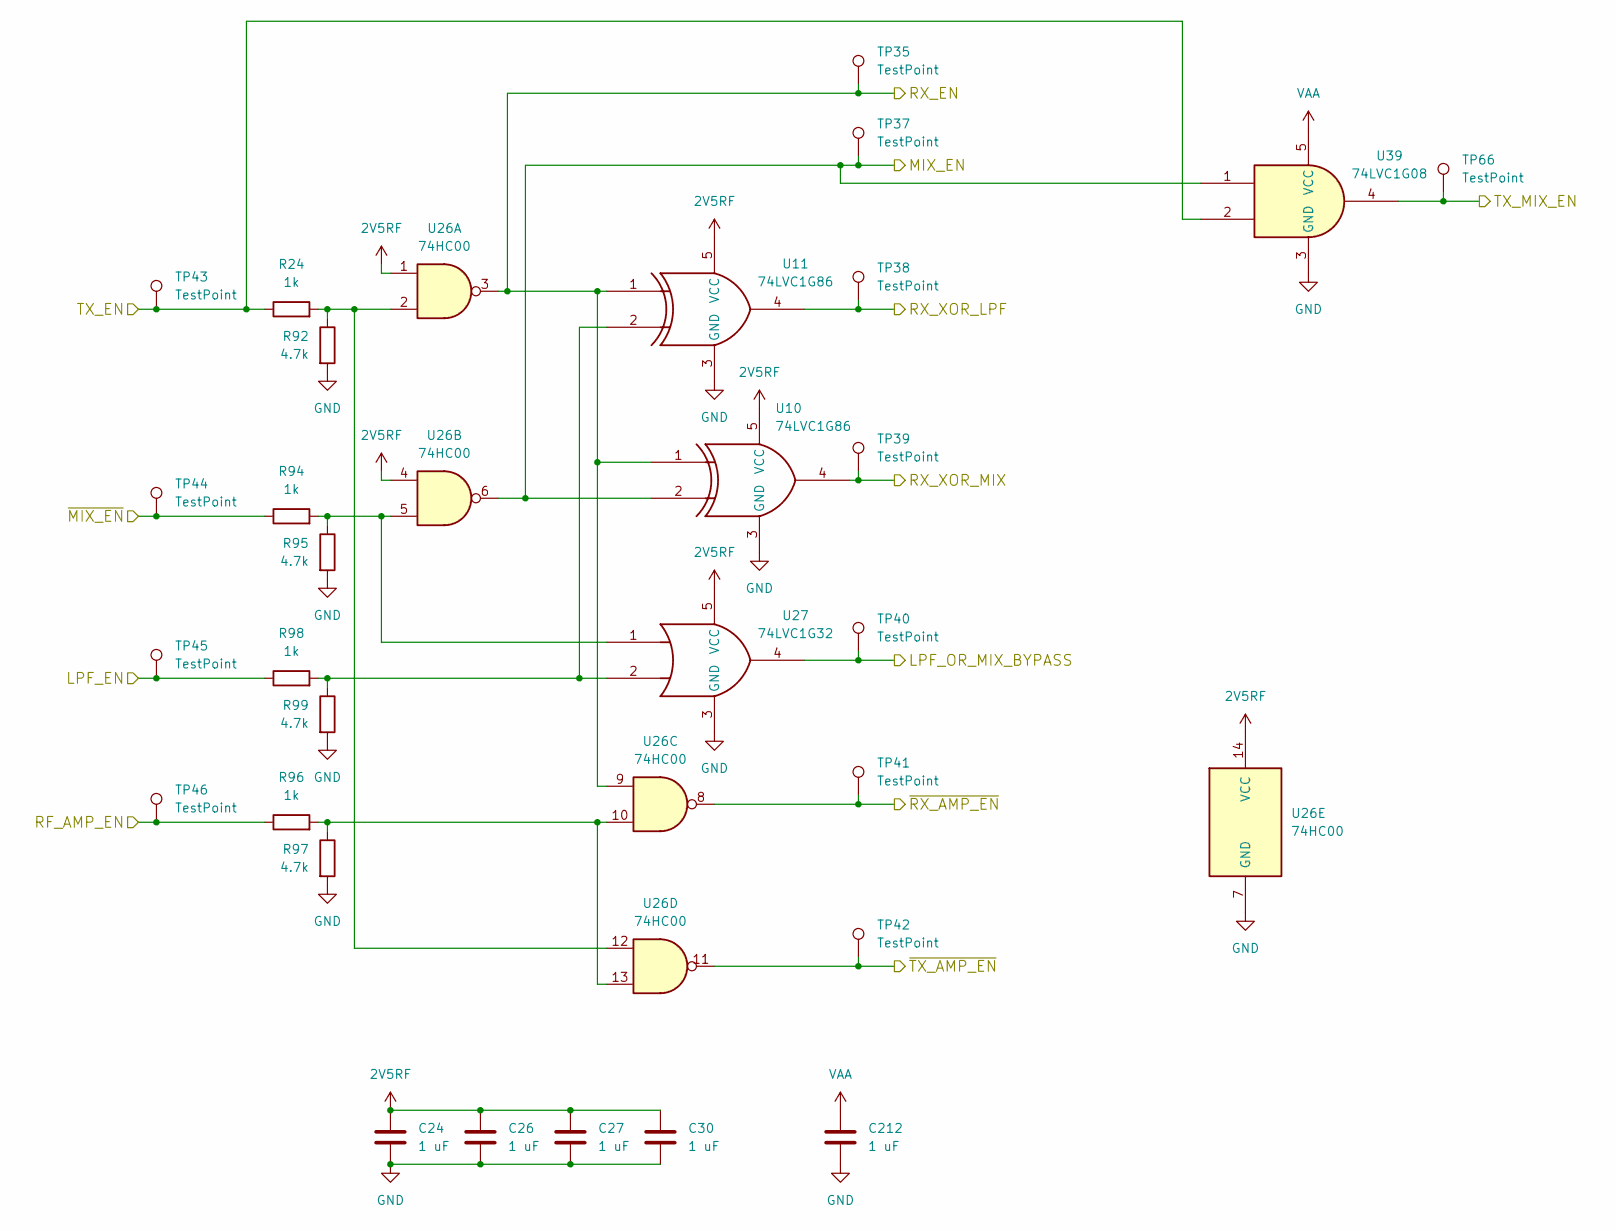
[picture p12: schematic switch_control.kicad_sch]

Parts:
C24, C26, C27, C30, C212: 1 uF; C_0201_0603Metric; Part Number GRM033R61A105ME44D
R24, R94, R96, R98: 1k; R_0201_0603Metric; Part Number RC0201FR-071KL
R92, R95, R97, R99: 4.7k; R_0201_0603Metric; Part Number RC0201FR-074K7L
TP35, TP37, TP38, TP39, TP40, TP41, TP42, TP43, TP44, TP45, TP46, TP66: TestPoint; TestPoint_Pad_D1.0mm
U10, U11: 74LVC1G86; SOT-353_SC-70-5; Part Number SN74LVC1G86DCKR
U26: 74HC00; DHVQFN-14-1EP_2.5x3mm_P0.5mm_EP1x1.5mm; Part Number 74HC00BQ,115
U27: 74LVC1G32; SOT-353_SC-70-5; Part Number SN74LVC1G32DCKR
U39: 74LVC1G08; SOT-353_SC-70-5; Part Number SN74LVC1G08DCKR

Connections:
2V5RF: C24.1, C26.1, C27.1, C30.1, U10.5 (VCC), U11.5 (VCC), U26.1, U26.4, U26.14 (VCC), U27.5 (VCC)
GND: C24.2, C26.2, C27.2, C30.2, C212.2, R92.2, R95.2, R97.2, R99.2, U10.3 (GND), U11.3 (GND), U26.7 (GND), U27.3 (GND), U39.3 (GND)
LPF_EN: R98.1, TP45.1
LPF_OR_MIX_BYPASS: TP40.1, U27.4
MIX_EN: TP37.1, U10.2, U26.6, U39.1
unnamed: R24.2, R92.1, U26.2, U26.12
unnamed: R94.2, R95.1, U26.5, U27.1
unnamed: R96.2, R97.1, U26.10, U26.13
unnamed: R98.2, R99.1, U11.2, U27.2
RF_AMP_EN: R96.1, TP46.1
RX_EN: TP35.1, U10.1, U11.1, U26.3, U26.9
RX_XOR_LPF: TP38.1, U11.4
RX_XOR_MIX: TP39.1, U10.4
TX_EN: R24.1, TP43.1, U39.2
TX_MIX_EN: TP66.1, U39.4
VAA: C212.1, U39.5 (VCC)
~MIX_EN: R94.1, TP44.1
~RX_AMP_EN: TP41.1, U26.8
~TX_AMP_EN: TP42.1, U26.11
