xjordanx/q-radio/usb.kicad_sch

## KiCad design usb.kicad_sch (2026-08-11)

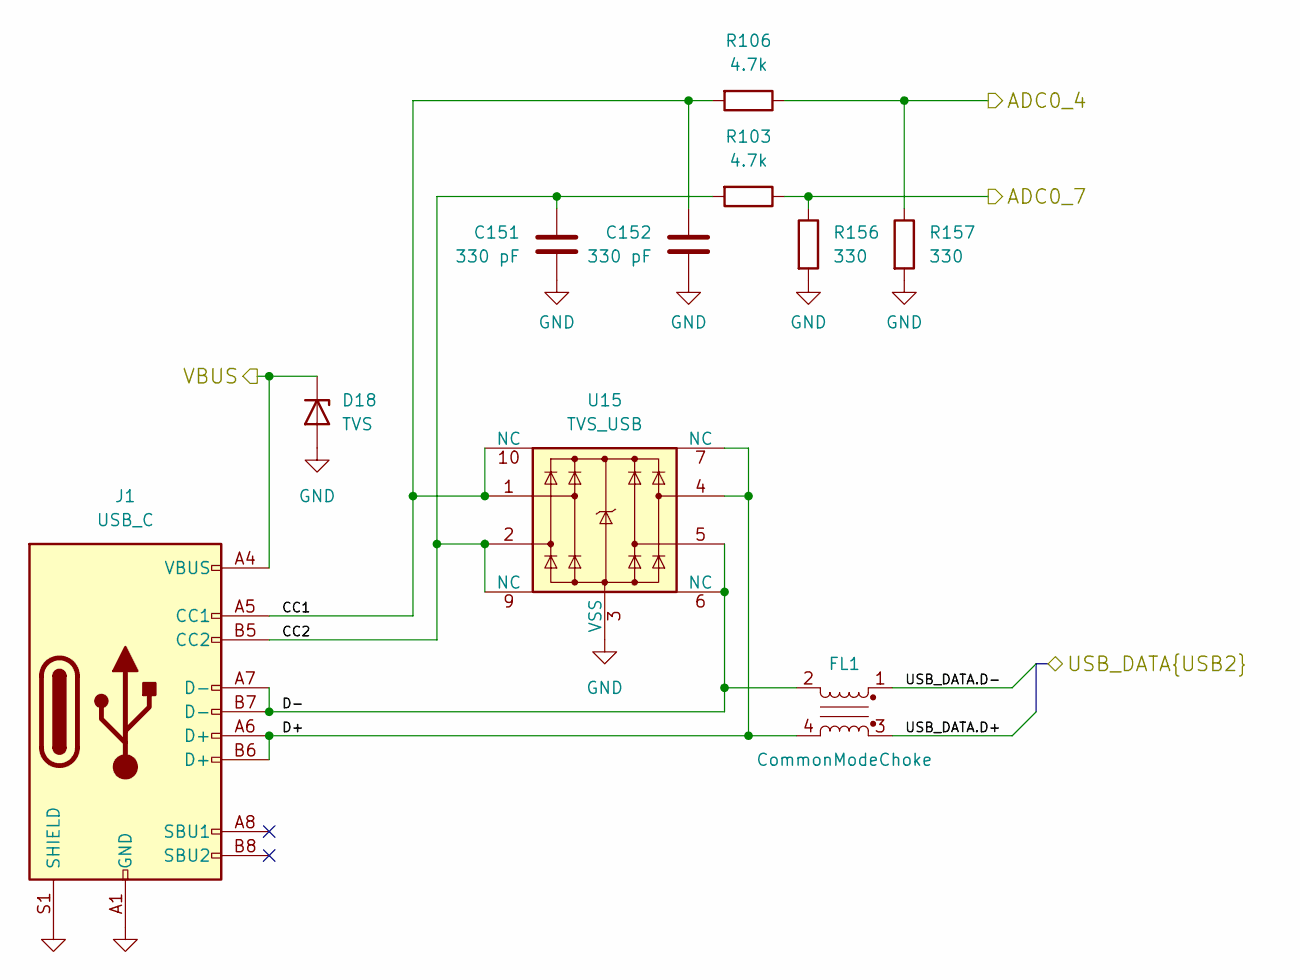
[picture p13: schematic usb.kicad_sch]

Parts:
C151, C152: 330 pF; C_0201_0603Metric; Part Number GRM0335C1E331JA01D
D18: TVS; TSLP-2-19; Part Number ESD8D12V
FL1: CommonModeChoke; L_CommonModeChoke_Murata_DLM0NS; Part Number DLM0NSB280HY2D
J1: USB_C; USB_C_Receptacle_HRO_TYPE-C-31-M-12; Part Number USB-TYPE-C-019
R103, R106: 4.7k; R_0201_0603Metric; Part Number RC0201FR-074K7L
R156, R157: 330; R_0201_0603Metric; Part Number RC0201JR-07330RL
U15: TVS_USB; Diodes_UDFN-10_1.0x2.5mm_P0.5mm; Part Number TPAZ1143-04F

Connections:
ADC0_4: R106.1, R157.1
ADC0_7: R103.1, R156.1
CC1: C152.1, J1.A5 (CC1), R106.2, U15.1, U15.10 (NC)
CC2: C151.1, J1.B5 (CC2), R103.2, U15.2, U15.9 (NC)
D+: FL1.4, J1.A6 (D+), J1.B6 (D+), U15.4, U15.7 (NC)
D-: FL1.2, J1.A7 (D-), J1.B7 (D-), U15.5, U15.6 (NC)
GND: C151.2, C152.2, D18.2 (A), J1.A1 (GND), J1.A12 (GND), J1.B1 (GND), J1.B12 (GND), J1.S1 (SHIELD), R156.2, R157.2, U15.3 (VSS), U15.8 (VSS)
USB_DATA.D+: FL1.3
USB_DATA.D-: FL1.1
VBUS: D18.1 (K), J1.A4 (VBUS), J1.A9 (VBUS), J1.B4 (VBUS), J1.B9 (VBUS)
